HALIMA-BOUCAR-MANI-ORTHE/CODE-SYSTEME-INTELLIGENT-BASE-SUR-ESP32-ET-GSM-SENTINELLE/@1SYSTEME-SENTINELLE.png

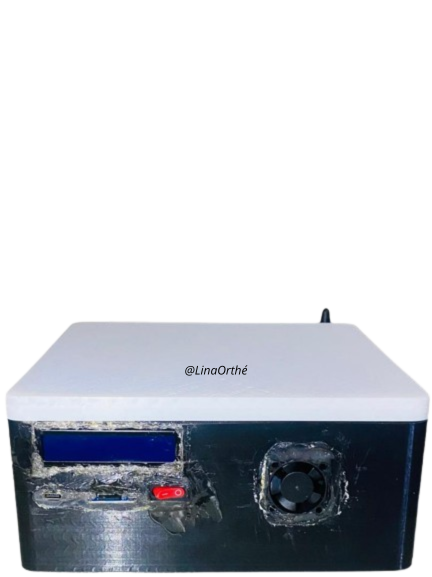
@1SYSTEME-SENTINELLE.png
