HALIMA-BOUCAR-MANI-ORTHE/CODE-SYSTEME-INTELLIGENT-BASE-SUR-ESP32-ET-GSM-SENTINELLE/@2SYSTEME-SENTINELLE.png

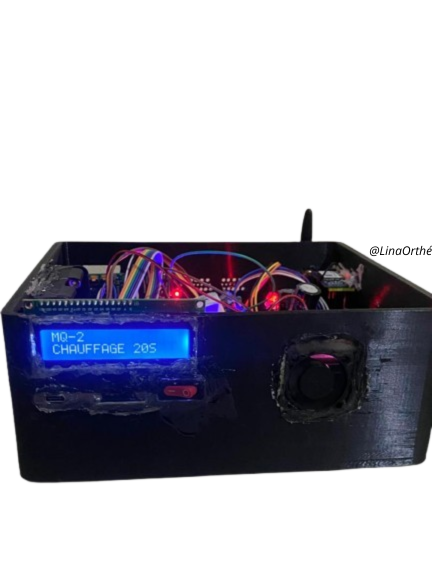
@2SYSTEME-SENTINELLE.png
