HALIMA-BOUCAR-MANI-ORTHE/CODE-SYSTEME-INTELLIGENT-BASE-SUR-ESP32-ET-GSM-SENTINELLE/README.md

# CODE-SYSTEME-INTELLIGENT-BASE-SUR-ESP32-ET-GSM-SENTINELLE
Système intelligent de surveillance et de sécurité en temps réel basé sur ESP32, SIM800L, MPU6050, MQ-2, PIR, DHT11 et carte microSD.

Autrice 
Halima BOUCAR MANI ORTHÉ
www.linkedin.com/in/boucar-mani-orthe-halima
