HALIMA-BOUCAR-MANI-ORTHE/CODE-SYSTEME-INTELLIGENT-BASE-SUR-ESP32-ET-GSM-SENTINELLE/(commit log)

2026-08-03 Ajout du projet SENTINELLE - Système intelligent
    Publication du projet SENTINELLE, un système embarqué intelligent de surveillance et de sécurité développé autour de l’ESP32. Le dépôt comprend le code source complet, le rapport du projet, les schémas et les images du prototype. Le système intègre la détection de gaz, de mouvement, de bruit, de chocs, ainsi que la surveillance de la température et de l’humidité, avec notifications par SMS, appels GSM, journalisation sur carte microSD et affichage sur écran LCD I2C.
2026-08-03 Ajout du projet SENTINELLE - Système intelligent
    Publication du projet SENTINELLE, un système embarqué intelligent de surveillance et de sécurité développé autour de l'ESP32. Le dépôt comprend le code source complet, le rapport du projet, les schémas et les images du prototype. Le système intègre la détection de gaz, de mouvement, de bruit, de chocs, ainsi que la surveillance de la température et de l'humidité, avec notifications par SMS, appels GSM, journalisation sur carte microSD et affichage sur écran LCD I2C.
2026-08-05 SENTINELLE - Système intelligent
    Programme du SENTINELLE, un système embarqué intelligent de surveillance et de sécurité développé autour de l'ESP32. Le dépôt comprend le code source complet, le rapport du projet, les schémas et les images du prototype. Le système intègre la détection de gaz, de mouvement, de bruit, de chocs, ainsi que la surveillance de la température et de l'humidité, avec notifications par SMS, appels GSM, journalisation sur carte microSD et affichage sur écran LCD I2C.
2026-08-05 SENTINELLE - Système intelligent
    Programme du SENTINELLE, un système embarqué intelligent de surveillance et de sécurité développé autour de l’ESP32. Le dépôt comprend le code source complet, le rapport du projet, les schémas et les images du prototype. Le système intègre la détection de gaz, de mouvement, de bruit, de chocs, ainsi que la surveillance de la température et de l’humidité, avec notifications par SMS, appels GSM, journalisation sur carte microSD et affichage sur écran LCD I2C.
2026-08-05 CODE-SYSTEME-INTELLIGENT-BASE-SUR-ESP32-ET-GSM-SENTINELLE
    Système intelligent de surveillance et de sécurité en temps réel basé sur ESP32, SIM800L, MPU6050, MQ-2, PIR, DHT11 et carte microSD.
